tuanphan12/Smart-Breadboard/Documentation/SB_doc.tex

\documentclass{article}
\usepackage{graphicx}
\usepackage[margin=0.75in]{geometry}
\usepackage{wrapfig}
\usepackage{array}
\usepackage[table]{xcolor}
\usepackage[export]{adjustbox}

\setlength{\arrayrulewidth}{0.60mm}
\renewcommand{\arraystretch}{1.1}

\title{Smart Breadboard Documentation}
\begin{document}
\maketitle

\section{Pinout}
\begin{table}[h]
\begin{wrapfigure}{r}{0.5\textwidth}
    \centering
    
\end{wrapfigure}
\rowcolors{3}{blue!30}{white!30}
\begin{tabular}{|m{2.5cm}|m{1cm}|m{2.5cm}|}
\hline
\multicolumn{3}{|c|}{Main} \\
\hline
PCB Board &  & Teensy Pinout \\
\hline
1 & EN & 4 \\
2 & S0 & 12 \\
3 & S1 & 11 \\
4 & S2 & 10 \\
5 & S3 & 9 \\
6 & S4 & A0 \\
7 & VCC & 3.3 V \\
8 & GND & GND \\
\hline
\end{tabular}
\end{table}

\begin{table}[h]
\rowcolors{3}{blue!30}{white!30}
\begin{tabular}{|m{2.5cm}|m{1cm}|m{2.5cm}|}
\hline
\multicolumn{3}{|c|}{Auxillary} \\
\hline
PCB Board &  & Teensy Pinout \\
\hline
1 & S0 & 8 \\
2 & S1 & 7 \\
3 & S2 & 6 \\
4 & S3 & 5 \\
\hline
\end{tabular}
\end{table}

\begin{table}[h]
\rowcolors{3}{blue!30}{white!30}
\begin{tabular}{|m{3.23cm}|m{3.23cm}|}
\hline
\multicolumn{2}{|c|}{Teensy Breakout Board} \\
\hline
Breakout Board  & Teensy Pinout \\
\hline
1 & 3.3 V \\
2 & GND \\
3 & GND \\
4 & A0 \\
5 & 4 \\
6 & 5 \\
7 & 6 \\
8 & 7 \\
9 & 8 \\
10 & 9 \\
11 & 10 \\
12 & 11 \\
13 & 12 \\
\hline
\end{tabular}
\end{table}

\section{Description}
\begin{wrapfigure}{r}{4cm}
    \centering
    
\end{wrapfigure}
Left column  : 0 - 61 \\
Left NEG rail: 62 \\
Left POS rail: 63 \\
Right column  : 64 - 125 \\
Right NEG rail: 127 \\
Right POS rail; 126 \\[18pt]
\textbf{\underline{Format to control}}: \\
\textit{Evaluate all nodes:} \\
all* \\~\\
\textit{Evaluate a single node with time:} \\
nodeIndex,samplingRate + ``;" + ``single" \\
(et. 2,10;single for node 2 with sampling rate of 2)

\section{Materials and Assembly Process}
\begin{table}[h]
\subsection{Materials}
\begin{tabular}{|m{3cm}|m{5.25cm}|}
\hline
Quantity & Item Description \\
\hline
9 & 16-channel multiplexer \\
9 & 100k resistor \\
9 & 0.1uF capacitor \\
6 & Flat head 4-40 x 5/8" screw \\
8 & Flat head 6-32 x 3/4" screw \\
8 & Acrylic spacers (3.25 mm thick) \\
8 & Nylon spacers 6-32 \\
1 & Acrylic sheet clear \\
1 & Teensy microcontroller \\
256 & Pogo pins \\
\hline
\end{tabular}
\end{table}

\subsection{Assembly Process}
- Solder the surface mount components to the PCB \\
- Use another blank PCB board as a rig to solder the pogo pins \\
- Laser cut the 6mm thick acrylic sheet \\
- Check with PCB for up/down orientation \\
- Countersink the acrylic using the mill press \\
- Tap the 4-40 holes for the solderless breadboard \\
- Place the 6-32 screws in first and then secure the breadboard using flat head screws (Note: If the acrylic threading could not hold the upward force of the PCB, consider using slightly longer screws and secure with 4-40 nuts.) \\

\end{document}
