tuanphan12/Smart-Breadboard/Documentation/SB_doc.pdf

# Smart Breadboard Documentation

November 17, 2017

## 1 Pinout

Main
PCB Board | | Teensy Pinout
1 2 3 4 5 6 7 8 | EN S0 S1 S2 S3 S4 VCC GND | 4 12 11 10 9 A0 3.3 V GND

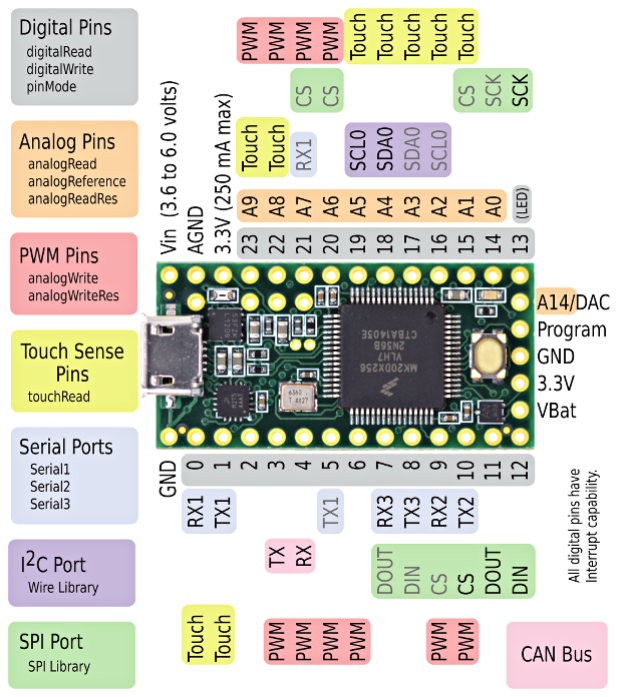
[picture p3: figure]

Auxillary
PCB Board | | Teensy Pinout
1 2 3 4 | S0 S1 S2 S3 | 8 7 6 5

Teensy Breakout Board
Breakout Board | Teensy Pinout
1 2 3 4 5 6 7 8 9 10 11 12 13 | 3.3 V GND GND A0 4 5 6 7 8 9 10 11 12

1

## 2 Description

Left column : 0 - 61
Left NEG rail: 62
Left POS rail: 63
Right column : 64 - 125
Right NEG rail: 127
Right POS rail; 126

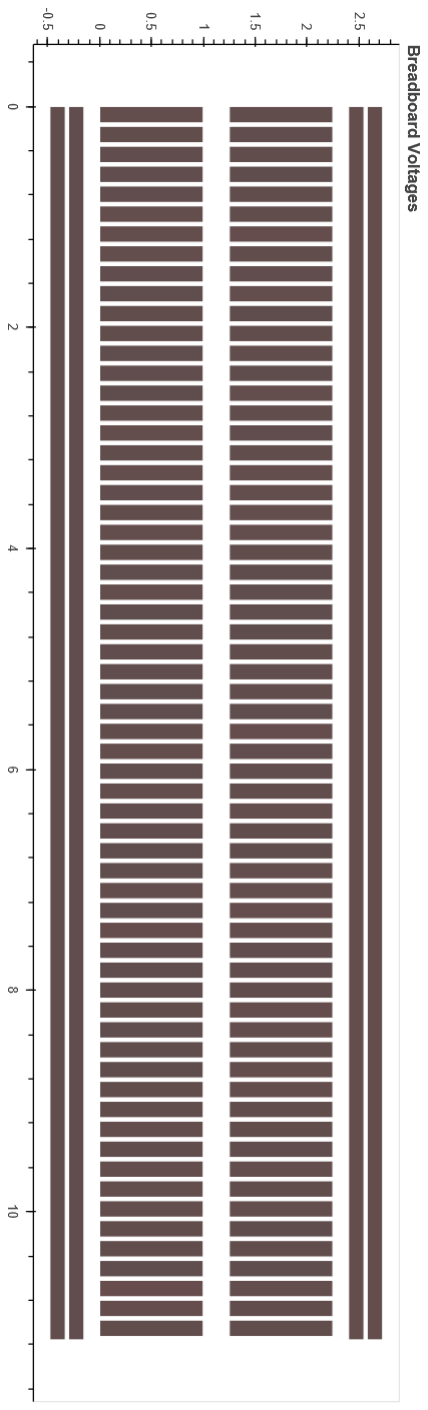
[picture p4: figure]

Format to control:
Evaluate all nodes:
all*

Evaluate a single node with time: nodeIndex,samplingRate + “;” + “single”
(et. 2,10;single for node 2 with sampling rate of 2)

## 3 Materials and Assembly Process

### 3.1 Materials

Quantity | Item Description
9 9 9 6 8 8 8 1 1 256 | 16-channel multiplexer 100k resistor 0.1uF capacitor Flat head 4-40 x 5/8” screw Flat head 6-32 x 3/4” screw Acrylic spacers (3.25 mm thick) Nylon spacers 6-32 Acrylic sheet clear Teensy microcontroller Pogo pins

### 3.2 Assembly Process

- Solder the surface mount components to the PCB
- Use another blank PCB board as a rig to solder the pogo pins
- Laser cut the 6mm thick acrylic sheet
- Check with PCB for up/down orientation
- Countersink the acrylic using the mill press
- Tap the 4-40 holes for the solderless breadboard
- Place the 6-32 screws in first and then secure the breadboard using flat head screws (Note: If the acrylic threading could not hold the upward force of the PCB, consider using slightly longer screws and secure with 4-40 nuts.)

2
