tuanphan12/Smart-Breadboard/9Mux_v5.brd

## EAGLE design 9Mux_v5.brd (2017-04-04)

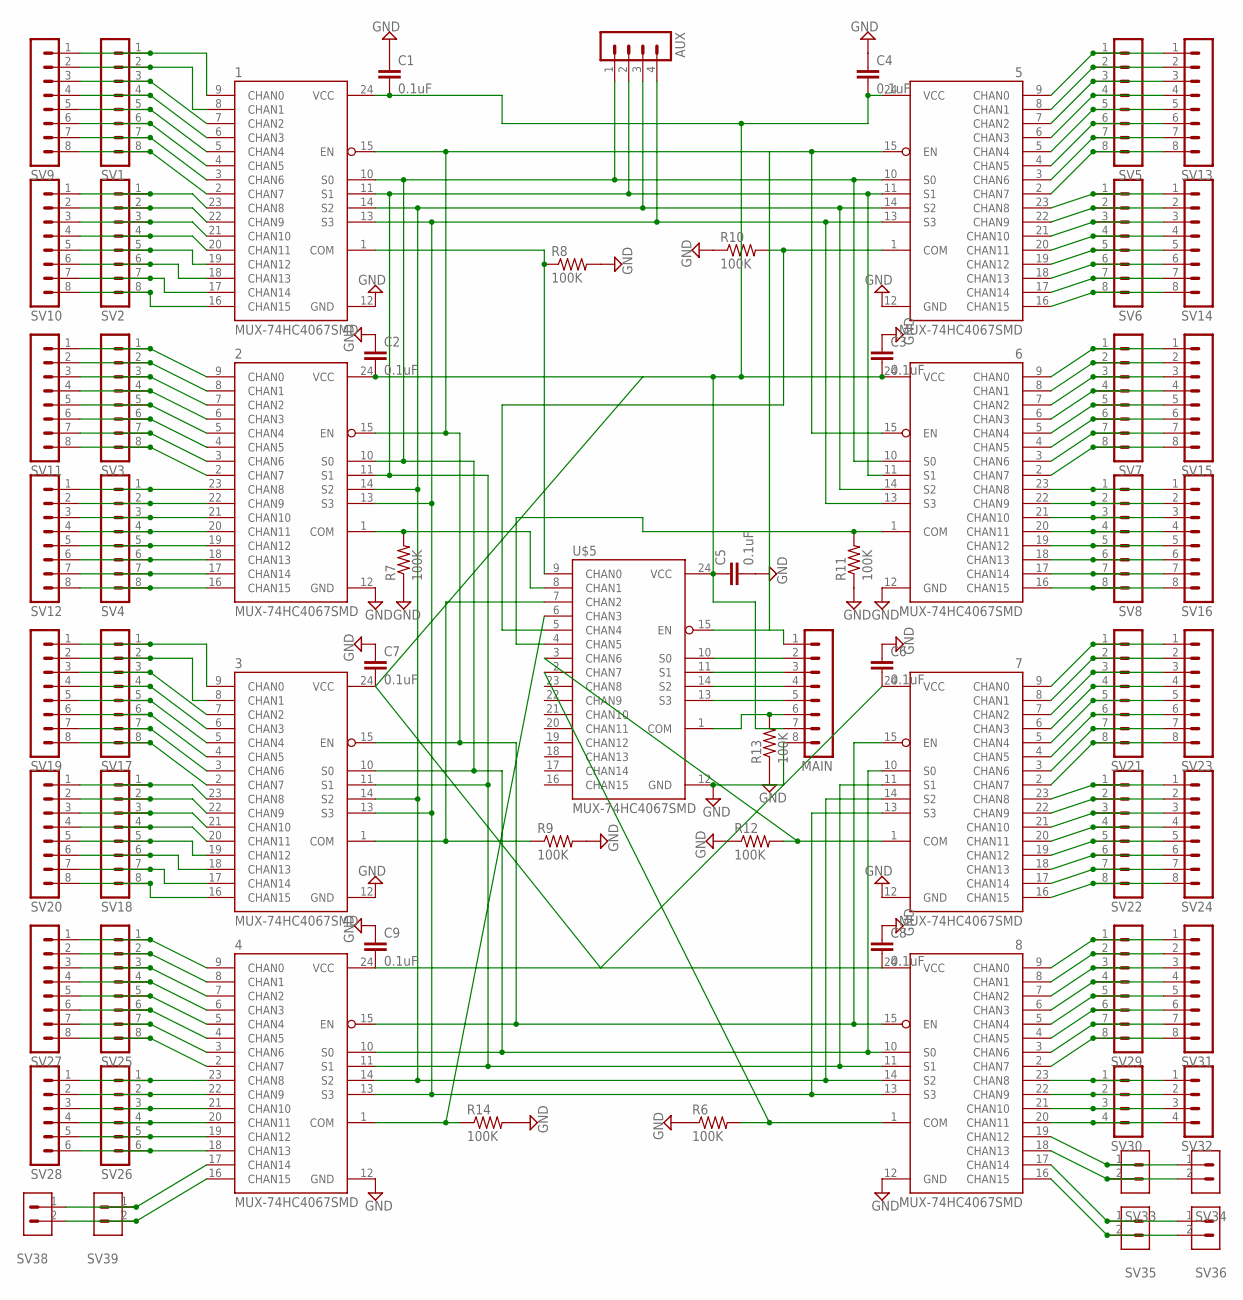
[picture p5: schematic 9Mux_v5.sch]

Parts:
1, 2, 3, 4, 5, 6, 7, 8: MUX-74HC4067SMD; SSOP24
AUX: MA04-1
C1, C2, C3, C4, C5, C6, C7, C8, C9: 0.1uF; 0603-CAP
MAIN: MA08-1
R6, R7, R8, R9, R10, R11, R12, R13, R14: 100K; 0603-RES
SV1, SV2, SV3, SV4, SV5, SV6, SV7, SV8, SV9, SV10, SV11, SV12, SV13, SV14, SV15, SV16, SV17, SV18, SV19, SV20, SV21, SV22, SV23, SV24, SV25, SV27, SV29, SV31: MA08-1
SV26, SV28: MA06-1
SV30, SV32: MA04-1
SV33, SV34, SV35, SV36, SV38, SV39: MA02-1; MA03-1
U$5: MUX-74HC4067SMD; SSOP24

Connections:
GND: 1.12 (GND), 2.12 (GND), 3.12 (GND), 4.12 (GND), 5.12 (GND), 6.12 (GND), 7.12 (GND), 8.12 (GND), C1.1, C2.1, C3.1, C4.1, C5.2, C6.1, C7.1, C8.1, C9.1, MAIN.8, R6.1, R7.1, R8.2, R9.2, R10.1, R11.1, R12.1, R13.1, R14.2, U$5.12 (GND)
MAIN: 1.11 (S1), 2.11 (S1), 3.11 (S1), 4.11 (S1), 5.11 (S1), 6.11 (S1), 7.11 (S1), 8.11 (S1), AUX.2
unnamed: 1.9 (CHAN0), SV1.1, SV9.1
unnamed: 1.8 (CHAN1), SV1.2, SV9.2
unnamed: 1.16 (CHAN15), SV2.8, SV10.8
unnamed: 1.17 (CHAN14), SV2.7, SV10.7
unnamed: 1.18 (CHAN13), SV2.6, SV10.6
unnamed: 2.8 (CHAN1), SV3.2, SV11.2
unnamed: 1.19 (CHAN12), SV2.5, SV10.5
unnamed: 1.20 (CHAN11), SV2.4, SV10.4
unnamed: 1.21 (CHAN10), SV2.3, SV10.3
unnamed: 1.22 (CHAN9), SV2.2, SV10.2
unnamed: 1.23 (CHAN8), SV2.1, SV10.1
unnamed: 1.7 (CHAN2), SV1.3, SV9.3
unnamed: 1.6 (CHAN3), SV1.4, SV9.4
unnamed: 1.5 (CHAN4), SV1.5, SV9.5
unnamed: 1.4 (CHAN5), SV1.6, SV9.6
unnamed: 1.3 (CHAN6), SV1.7, SV9.7
unnamed: 1.2 (CHAN7), SV1.8, SV9.8
unnamed: 2.9 (CHAN0), SV3.1, SV11.1
unnamed: 2.7 (CHAN2), SV3.3, SV11.3
unnamed: 2.6 (CHAN3), SV3.4, SV11.4
unnamed: 2.5 (CHAN4), SV3.5, SV11.5
unnamed: 5.5 (CHAN4), SV5.5, SV13.5
unnamed: 2.4 (CHAN5), SV3.6, SV11.6
unnamed: 2.3 (CHAN6), SV3.7, SV11.7
unnamed: 2.2 (CHAN7), SV3.8, SV11.8
unnamed: 2.23 (CHAN8), SV4.1, SV12.1
unnamed: 2.22 (CHAN9), SV4.2, SV12.2
unnamed: 2.21 (CHAN10), SV4.3, SV12.3
unnamed: 2.20 (CHAN11), SV4.4, SV12.4
unnamed: 2.19 (CHAN12), SV4.5, SV12.5
unnamed: 2.18 (CHAN13), SV4.6, SV12.6
unnamed: 2.17 (CHAN14), SV4.7, SV12.7
unnamed: 2.16 (CHAN15), SV4.8, SV12.8
unnamed: 5.9 (CHAN0), SV5.1, SV13.1
unnamed: 5.8 (CHAN1), SV5.2, SV13.2
unnamed: 5.7 (CHAN2), SV5.3, SV13.3
unnamed: 5.6 (CHAN3), SV5.4, SV13.4
unnamed: 5.4 (CHAN5), SV5.6, SV13.6
unnamed: 5.3 (CHAN6), SV5.7, SV13.7
unnamed: 5.2 (CHAN7), SV5.8, SV13.8
unnamed: 5.23 (CHAN8), SV6.1, SV14.1
unnamed: 5.22 (CHAN9), SV6.2, SV14.2
unnamed: 5.21 (CHAN10), SV6.3, SV14.3
unnamed: 5.20 (CHAN11), SV6.4, SV14.4
unnamed: 5.19 (CHAN12), SV6.5, SV14.5
unnamed: 5.18 (CHAN13), SV6.6, SV14.6
unnamed: 5.17 (CHAN14), SV6.7, SV14.7
unnamed: 5.16 (CHAN15), SV6.8, SV14.8
unnamed: 6.9 (CHAN0), SV7.1, SV15.1
unnamed: 6.8 (CHAN1), SV7.2, SV15.2
unnamed: 6.7 (CHAN2), SV7.3, SV15.3
unnamed: 6.6 (CHAN3), SV7.4, SV15.4
unnamed: 6.5 (CHAN4), SV7.5, SV15.5
unnamed: 1.10 (S0), 2.10 (S0), 3.10 (S0), 4.10 (S0), 5.10 (S0), 6.10 (S0), 7.10 (S0), 8.10 (S0), AUX.1
unnamed: 6.4 (CHAN5), SV7.6, SV15.6
unnamed: 1.14 (S2), 2.14 (S2), 3.14 (S2), 4.14 (S2), 5.14 (S2), 6.14 (S2), 7.14 (S2), 8.14 (S2), AUX.3
unnamed: 6.3 (CHAN6), SV7.7, SV15.7
unnamed: 6.2 (CHAN7), SV7.8, SV15.8
unnamed: 6.23 (CHAN8), SV8.1, SV16.1
unnamed: 1.13 (S3), 2.13 (S3), 3.13 (S3), 4.13 (S3), 5.13 (S3), 6.13 (S3), 7.13 (S3), 8.13 (S3), AUX.4
unnamed: 1.15 (EN), 2.15 (EN), 3.15 (EN), 4.15 (EN), 5.15 (EN), 6.15 (EN), 7.15 (EN), 8.15 (EN), MAIN.1, U$5.15 (EN)
unnamed: 6.22 (CHAN9), SV8.2, SV16.2
unnamed: 6.21 (CHAN10), SV8.3, SV16.3
unnamed: 6.20 (CHAN11), SV8.4, SV16.4
unnamed: 6.19 (CHAN12), SV8.5, SV16.5
unnamed: 6.18 (CHAN13), SV8.6, SV16.6
unnamed: 6.17 (CHAN14), SV8.7, SV16.7
unnamed: 6.16 (CHAN15), SV8.8, SV16.8
unnamed: 1.1 (COM), R8.1, U$5.9 (CHAN0)
unnamed: 3.9 (CHAN0), SV17.1, SV19.1
unnamed: 3.8 (CHAN1), SV17.2, SV19.2
unnamed: 3.16 (CHAN15), SV18.8, SV20.8
unnamed: 2.1 (COM), R7.2, U$5.8 (CHAN1)
unnamed: 6.1 (COM), R11.2, U$5.4 (CHAN5)
unnamed: 5.1 (COM), R10.2, U$5.5 (CHAN4)
unnamed: MAIN.2, U$5.10 (S0)
unnamed: MAIN.3, U$5.11 (S1)
unnamed: MAIN.4, U$5.14 (S2)
unnamed: MAIN.5, U$5.13 (S3)
unnamed: MAIN.6, R13.2, U$5.1 (COM)
unnamed: 3.17 (CHAN14), SV18.7, SV20.7
unnamed: 3.18 (CHAN13), SV18.6, SV20.6
unnamed: 3.19 (CHAN12), SV18.5, SV20.5
unnamed: 3.20 (CHAN11), SV18.4, SV20.4
unnamed: 3.21 (CHAN10), SV18.3, SV20.3
unnamed: 3.22 (CHAN9), SV18.2, SV20.2
unnamed: 3.23 (CHAN8), SV18.1, SV20.1
unnamed: 3.7 (CHAN2), SV17.3, SV19.3
unnamed: 3.6 (CHAN3), SV17.4, SV19.4
unnamed: 3.5 (CHAN4), SV17.5, SV19.5
unnamed: 3.4 (CHAN5), SV17.6, SV19.6
unnamed: 3.3 (CHAN6), SV17.7, SV19.7
unnamed: 3.2 (CHAN7), SV17.8, SV19.8
unnamed: 7.9 (CHAN0), SV21.1, SV23.1
unnamed: 7.8 (CHAN1), SV21.2, SV23.2
unnamed: 7.7 (CHAN2), SV21.3, SV23.3
unnamed: 7.6 (CHAN3), SV21.4, SV23.4
unnamed: 7.5 (CHAN4), SV21.5, SV23.5
unnamed: 7.4 (CHAN5), SV21.6, SV23.6
unnamed: 7.3 (CHAN6), SV21.7, SV23.7
unnamed: 7.2 (CHAN7), SV21.8, SV23.8
unnamed: 7.23 (CHAN8), SV22.1, SV24.1
unnamed: 7.22 (CHAN9), SV22.2, SV24.2
unnamed: 7.21 (CHAN10), SV22.3, SV24.3
unnamed: 7.20 (CHAN11), SV22.4, SV24.4
unnamed: 7.19 (CHAN12), SV22.5, SV24.5
unnamed: 7.18 (CHAN13), SV22.6, SV24.6
unnamed: 7.17 (CHAN14), SV22.7, SV24.7
unnamed: 7.16 (CHAN15), SV22.8, SV24.8
unnamed: 4.9 (CHAN0), SV25.1, SV27.1
unnamed: 4.8 (CHAN1), SV25.2, SV27.2
unnamed: 4.7 (CHAN2), SV25.3, SV27.3
unnamed: 4.6 (CHAN3), SV25.4, SV27.4
unnamed: 4.5 (CHAN4), SV25.5, SV27.5
unnamed: 4.4 (CHAN5), SV25.6, SV27.6
unnamed: 4.3 (CHAN6), SV25.7, SV27.7
unnamed: 4.2 (CHAN7), SV25.8, SV27.8
unnamed: 4.23 (CHAN8), SV26.1, SV28.1
unnamed: 4.22 (CHAN9), SV26.2, SV28.2
unnamed: 4.21 (CHAN10), SV26.3, SV28.3
unnamed: 4.20 (CHAN11), SV26.4, SV28.4
unnamed: 4.19 (CHAN12), SV26.5, SV28.5
unnamed: 4.18 (CHAN13), SV26.6, SV28.6
unnamed: 4.17 (CHAN14), SV38.1, SV39.1
unnamed: 4.16 (CHAN15), SV38.2, SV39.2
unnamed: 8.9 (CHAN0), SV29.1, SV31.1
unnamed: 8.8 (CHAN1), SV29.2, SV31.2
unnamed: 8.7 (CHAN2), SV29.3, SV31.3
unnamed: 8.6 (CHAN3), SV29.4, SV31.4
unnamed: 8.5 (CHAN4), SV29.5, SV31.5
unnamed: 8.4 (CHAN5), SV29.6, SV31.6
unnamed: 8.3 (CHAN6), SV29.7, SV31.7
unnamed: 8.2 (CHAN7), SV29.8, SV31.8
unnamed: 8.23 (CHAN8), SV30.1, SV32.1
unnamed: 8.22 (CHAN9), SV30.2, SV32.2
unnamed: 8.21 (CHAN10), SV30.3, SV32.3
unnamed: 8.20 (CHAN11), SV30.4, SV32.4
unnamed: 3.1 (COM), R9.1, U$5.7 (CHAN2)
unnamed: 7.1 (COM), R12.2, U$5.3 (CHAN6)
unnamed: 4.1 (COM), R14.1, U$5.6 (CHAN3)
unnamed: 8.1 (COM), R6.2, U$5.2 (CHAN7)
unnamed: 1.24 (VCC), 2.24 (VCC), 3.24 (VCC), 4.24 (VCC), 5.24 (VCC), 6.24 (VCC), 7.24 (VCC), 8.24 (VCC), C1.2, C2.2, C3.2, C4.2, C5.1, C6.2, C7.2, C8.2, C9.2, MAIN.7, U$5.24 (VCC)
unnamed: 8.19 (CHAN12), SV33.1, SV34.1
unnamed: 8.18 (CHAN13), SV33.2, SV34.2
unnamed: 8.17 (CHAN14), SV35.1, SV36.1
unnamed: 8.16 (CHAN15), SV35.2, SV36.2

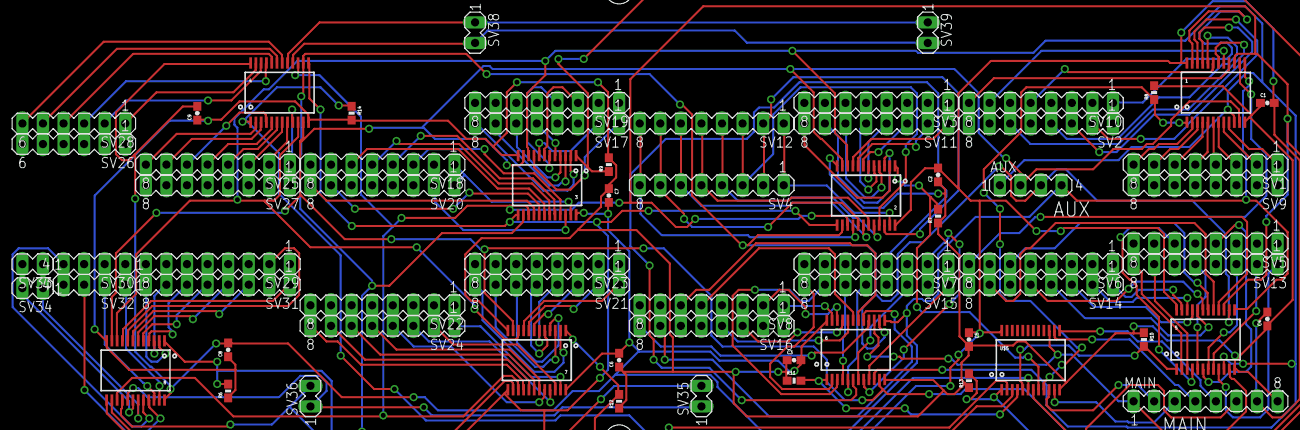
[picture p6: board 9Mux_v5.brd from above]

Board: 2 copper layers, 67 parts (0 on the bottom side), 148 nets.
