tuanphan12/Smart-Breadboard/Experiments/6_4_17/1.PNG

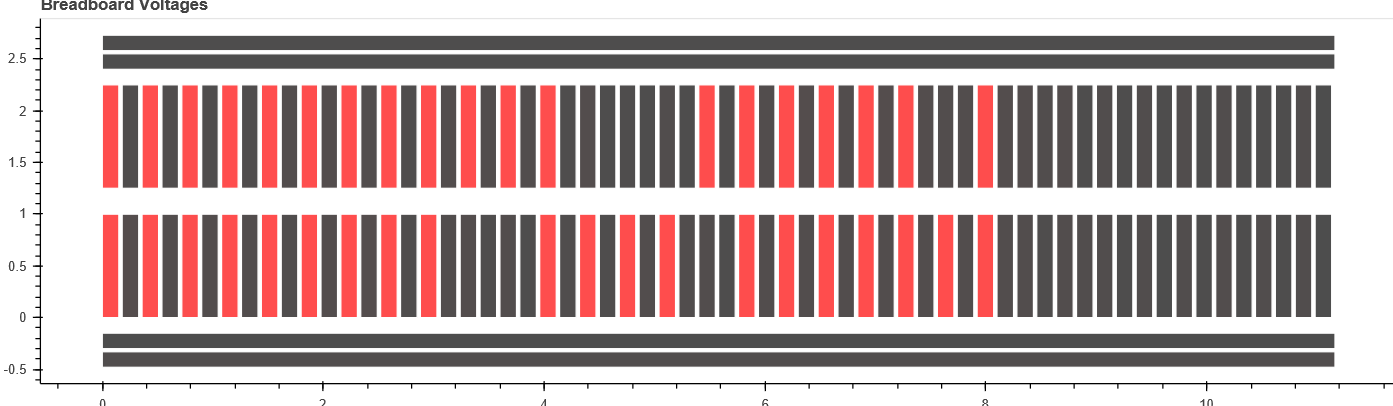
Experiments/6_4_17/1.PNG
