tuanphan12/Smart-Breadboard/Experiments/6_4_17/3.PNG

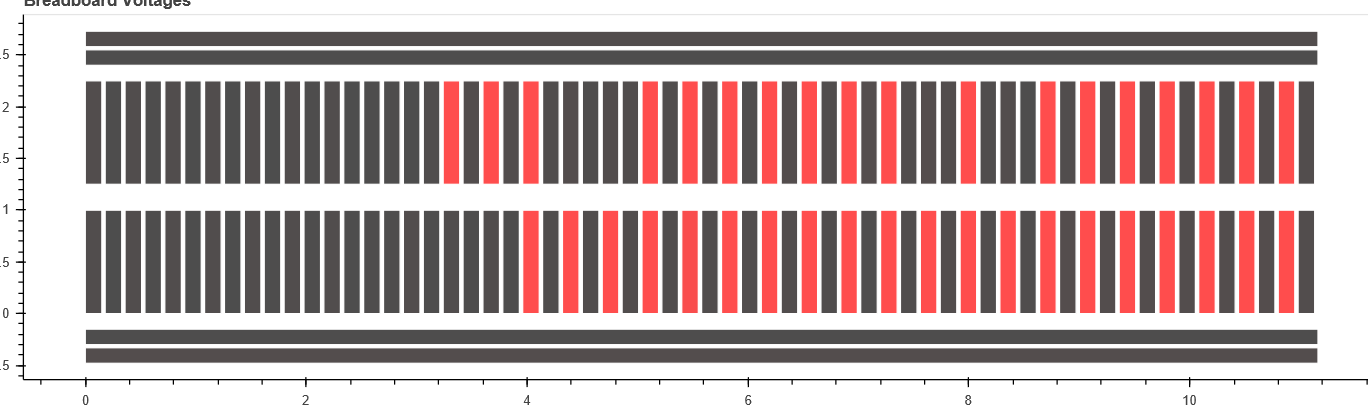
Experiments/6_4_17/3.PNG
