tuanphan12/Smart-Breadboard/(commit log)

2017-04-04 added some comments to the teensy code
2017-04-04 added the schematic and the board files. Also the Gerber files
2017-04-04 new files
    [9Mux_v5.brd, 9Mux_v5.sch, Teensy Board.brd, Teensy Board.sch]
2017-04-05 changes in Teensy Breakout Board
    [Teensy Board.brd, Teensy Board.sch]
2017-04-05 added the drill profile for the Gerber file
2017-04-11 update with current items, 4/11/2017
2017-05-22 added laser cuts
2017-07-18 latest lasercut
2017-08-05 added the assembling instructions
2017-08-25 adding in joes working copy of code and python...auto connect to teensy 4Hz run rate/page updating
